DD1984/roboremo_car/photo/car1.jpg

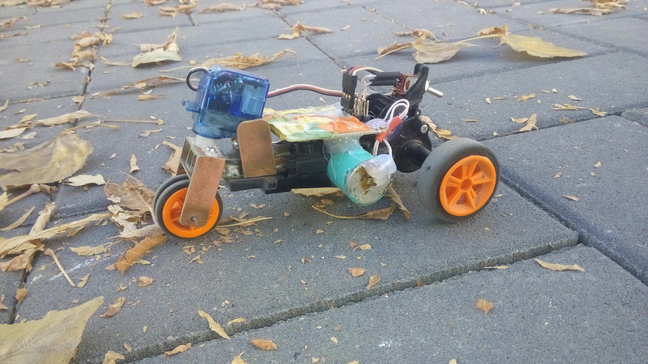
photo/car1.jpg
