DD1984/roboremo_car/photo/car2.jpg

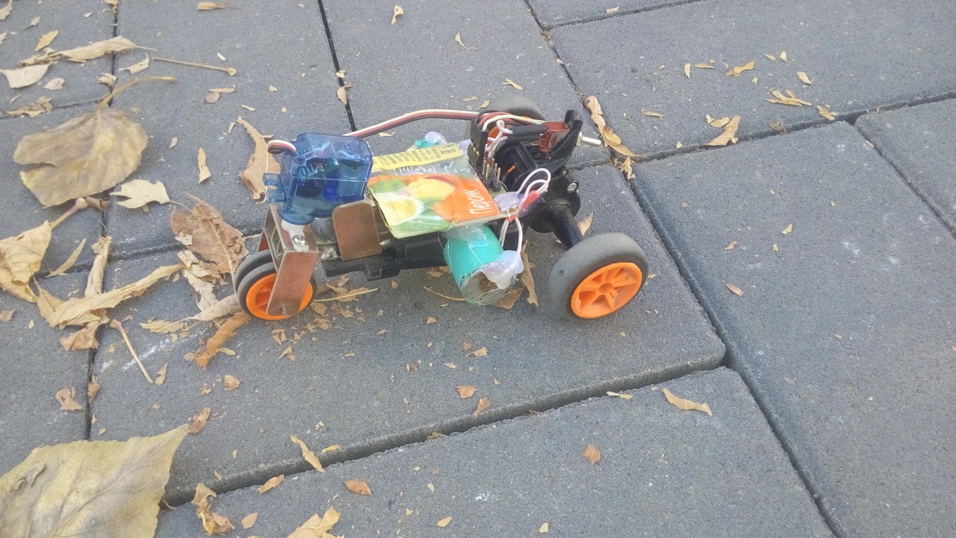
photo/car2.jpg
