DD1984/roboremo_car/pcb/rc.brd

## EAGLE design pcb/rc.brd (2018-10-22)

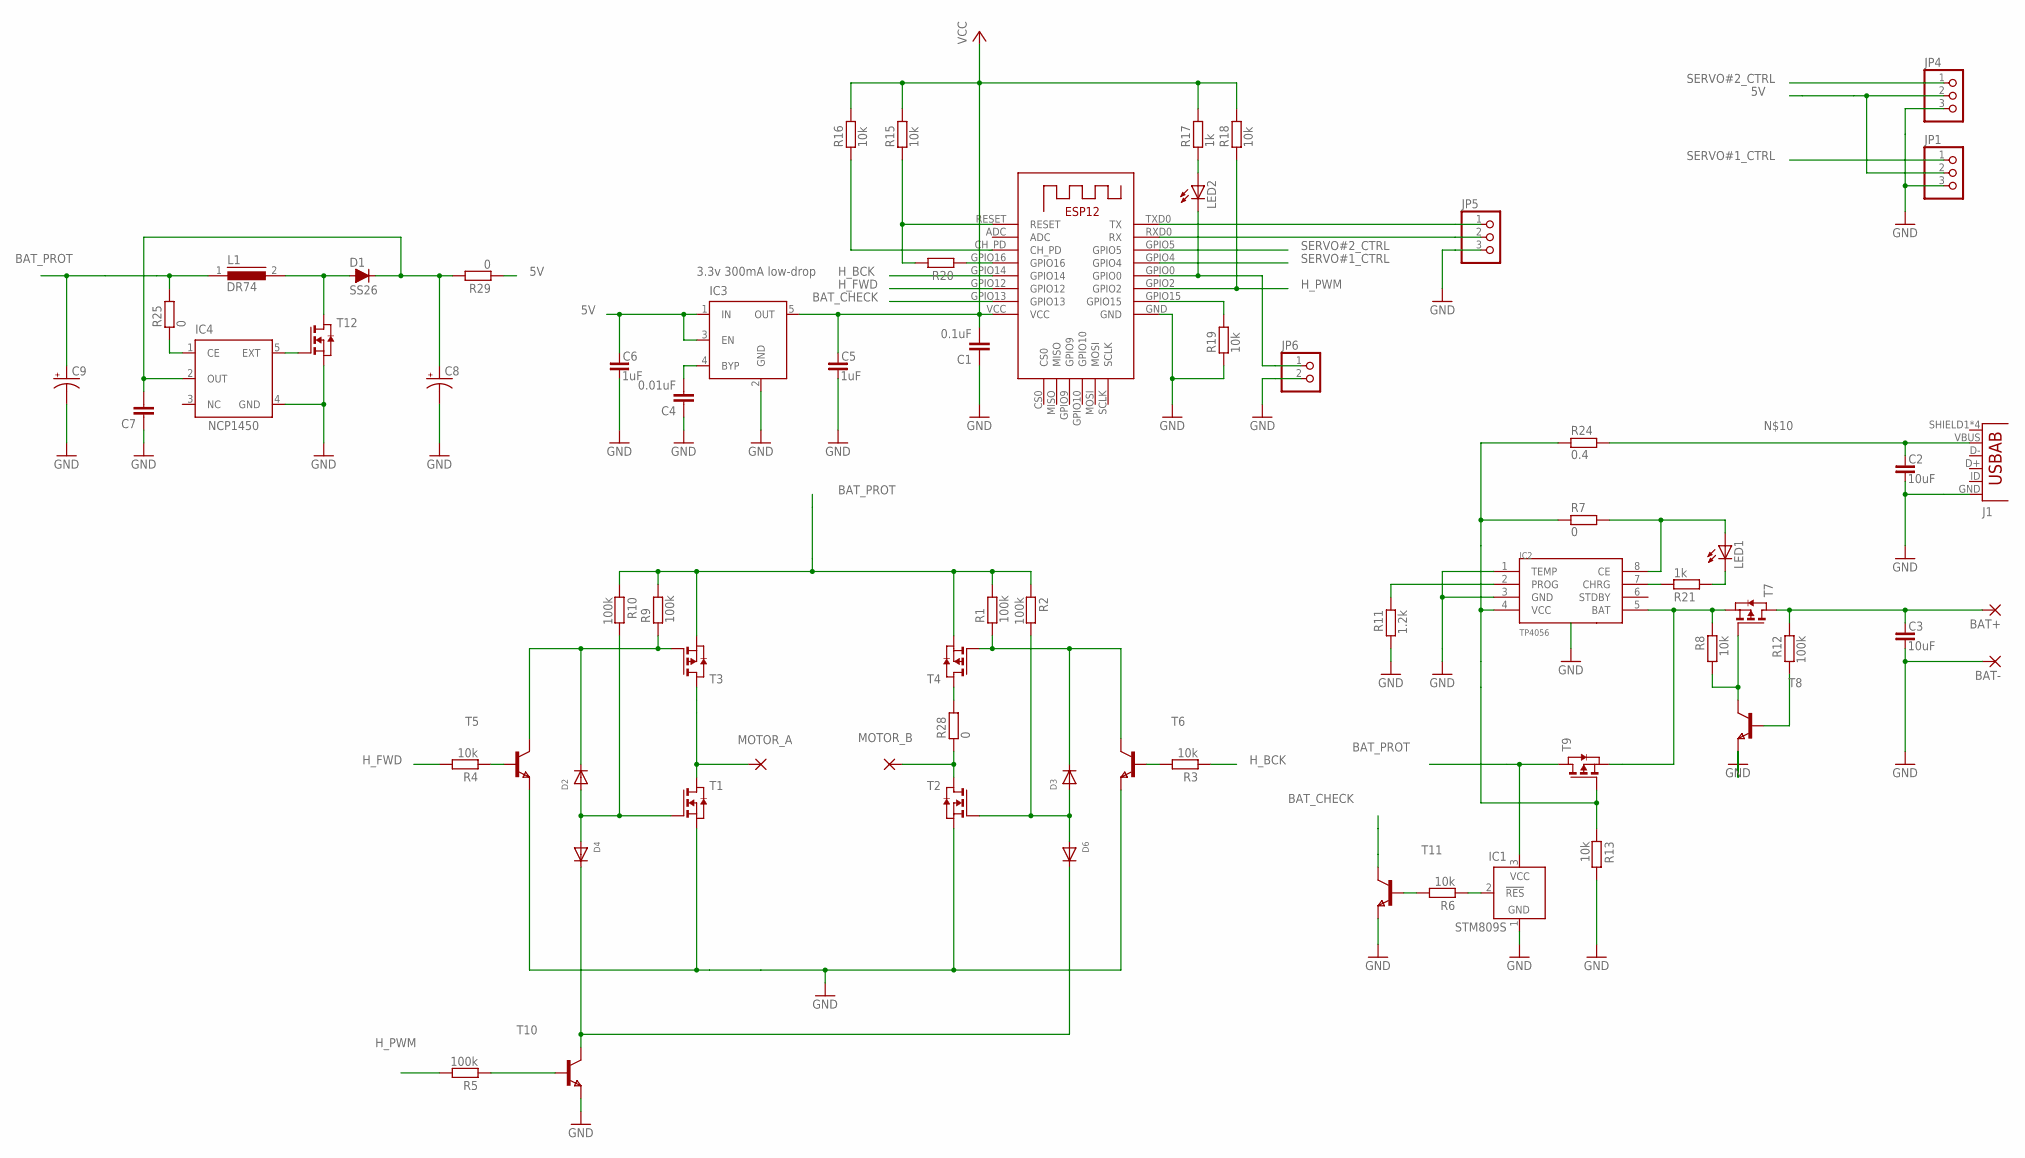
[picture p3: schematic rc.sch]

Parts:
BAT+: WIREPADSMD5-2,5; 5-2,5
BAT-: WIREPADSMD5-2,5; 5-2,5
C1: 0.1uF; C0805
C2, C3: 10uF; C1206
C4: 0.01uF; C0805
C5, C6: 1uF; C0805
C7: C-EUC0805; C0805
C8, C9: CPOL-USCT6032; CT6032
D1: SS26; SMB
D2, D3, D4, D6: DIODE_SOD-123FL; SOD-123FL
IC1: STM809S; SOT23B-3
IC2: TP4056; SOP-8
IC3: 3.3v 300mA low-drop; SOT23-5
IC4: NCP1450; SOT23-5
J1: USB-AB; USB-AB-MICRO-SMD
JP1, JP4, JP5: PINHD-1X3; 1X03
JP6: PINHD-1X2; 1X02
L1: DR74
LED1, LED2: LEDCHIPLED_0805; CHIPLED_0805
MOTOR_A: WIREPADSMD5-2,5; 5-2,5
MOTOR_B: WIREPADSMD5-2,5; 5-2,5
R1, R2, R5, R9, R10, R12: 100k; R0805
R3, R4, R6, R8, R13, R15, R16, R18, R19: 10k; R0805
R7, R25, R28, R29: 0; R1206
R11: 1.2k; R0805
R17, R21: 1k; R0805
R20: R_0805; R0805
R24: 0.4; R1206
T1, T2, T12: NMOSSOT23; SOT-23
T3, T4, T7, T9: PMOSSOT23; SOT-23
T5, T6, T8, T10, T11: NPNSOT23; SOT-23
U1: ESP-12

Connections:
5V: C6.1, IC3.1 (IN), IC3.3 (EN), JP1.2, JP4.2, R29.1
BAT+: BAT+.1, C3.1, R12.1, T7.1 (D)
BAT_CHECK: T11.1 (C), U1.GPIO13
BAT_CHRG: IC2.5 (BAT), R8.1, T7.2 (S), T9.2 (S)
BAT_PROT: C9.+, IC1.3 (VCC), L1.1, R1.2, R2.1, R9.2, R10.1, R25.2, T3.2 (S), T4.2 (S), T9.1 (D)
GND: BAT-.1, C1.1, C2.2, C3.2, C4.1, C5.2, C6.2, C7.1, C8.-, C9.-, IC1.1 (GND), IC2.1 (TEMP), IC2.3 (GND), IC2.HEATSINK, IC3.2 (GND), IC4.4 (GND), J1.GND, JP1.3, JP4.3, JP5.3, JP6.2, R11.2, R13.2, R19.1, T1.2 (S), T2.2 (S), T5.2 (E), T6.2 (E), T8.2 (E), T10.2 (E), T11.2 (E), T12.2 (S), U1.GND
H_BCK: R3.1, U1.GPIO14
H_FWD: R4.2, U1.GPIO12
H_PWM: R5.2, R18.1, U1.GPIO2
unnamed: D2.C, R9.1, T3.3 (G), T5.1 (C)
unnamed: IC2.8 (CE), LED1.A, R7.2
unnamed: D1.2 (A), L1.2, T12.1 (D)
unnamed: MOTOR_B.1, R28.1, T2.1 (D)
unnamed: R4.1, T5.3 (B)
unnamed: D2.A, D4.A, R10.2, T1.3 (G)
unnamed: R3.2, T6.3 (B)
unnamed: D3.C, R1.1, T4.3 (G), T6.1 (C)
unnamed: D3.A, D6.A, R2.2, T2.3 (G)
unnamed: C2.1, J1.VBUS, R24.2
unnamed: IC2.2 (PROG), R11.1
unnamed: R8.2, T7.3 (G), T8.1 (C)
unnamed: R6.2, T11.3 (B)
unnamed: R28.2, T4.1 (D)
unnamed: IC4.5 (EXT), T12.3 (G)
unnamed: R12.2, T8.3 (B)
unnamed: IC1.2 (!RES), R6.1
unnamed: IC4.1 (CE), R25.1
unnamed: R15.1, R20.2, U1.RESET
unnamed: R16.1, U1.CH_PD
unnamed: JP6.1, LED2.C, U1.GPIO0
unnamed: R20.1, U1.GPIO16
unnamed: LED2.A, R17.1
unnamed: C4.2, IC3.4 (BYP)
unnamed: R19.2, U1.GPIO15
unnamed: LED1.C, R21.2
unnamed: IC2.7 (CHRG), R21.1
unnamed: C7.2, C8.+, D1.1 (C), IC4.2 (OUT), R29.2
unnamed: D4.C, D6.C, T10.1 (C)
unnamed: R5.1, T10.3 (B)
unnamed: MOTOR_A.1, T1.1 (D), T3.1 (D)
RX: JP5.2, U1.RXD0 (RX)
SERVO#1_CTRL: JP1.1, U1.GPIO4
SERVO#2_CTRL: JP4.1, U1.GPIO5
TX: JP5.1, U1.TXD0 (TX)
VCC: C1.2, C5.1, IC3.5 (OUT), R15.2, R16.2, R17.2, R18.2, U1.VCC
V_CHRG: IC2.4 (VCC), R7.1, R13.1, R24.1, T9.3 (G)

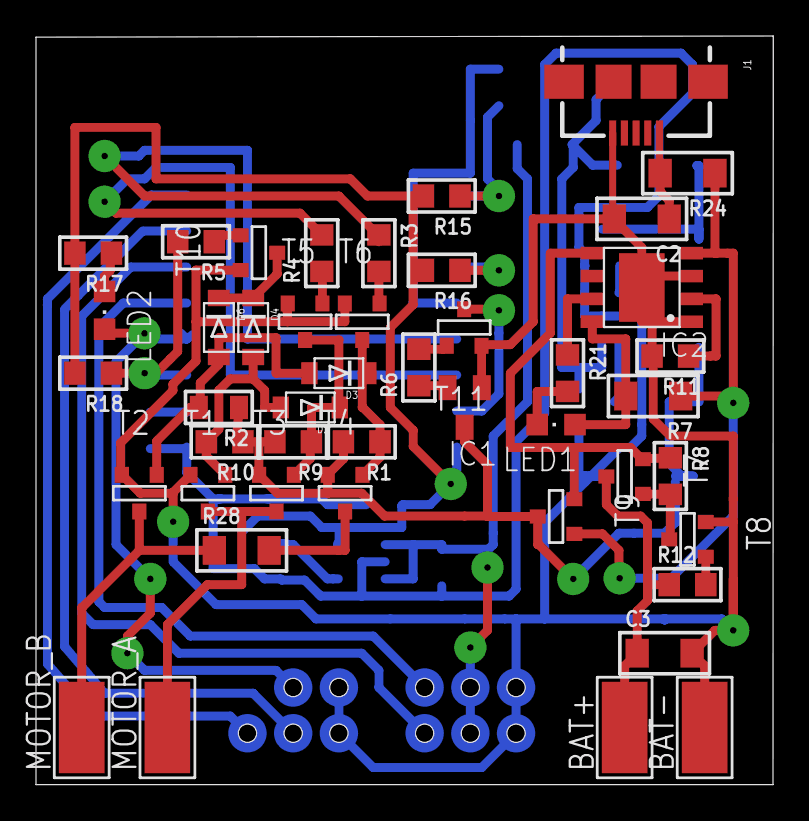
[picture p4: board rc.brd from above]

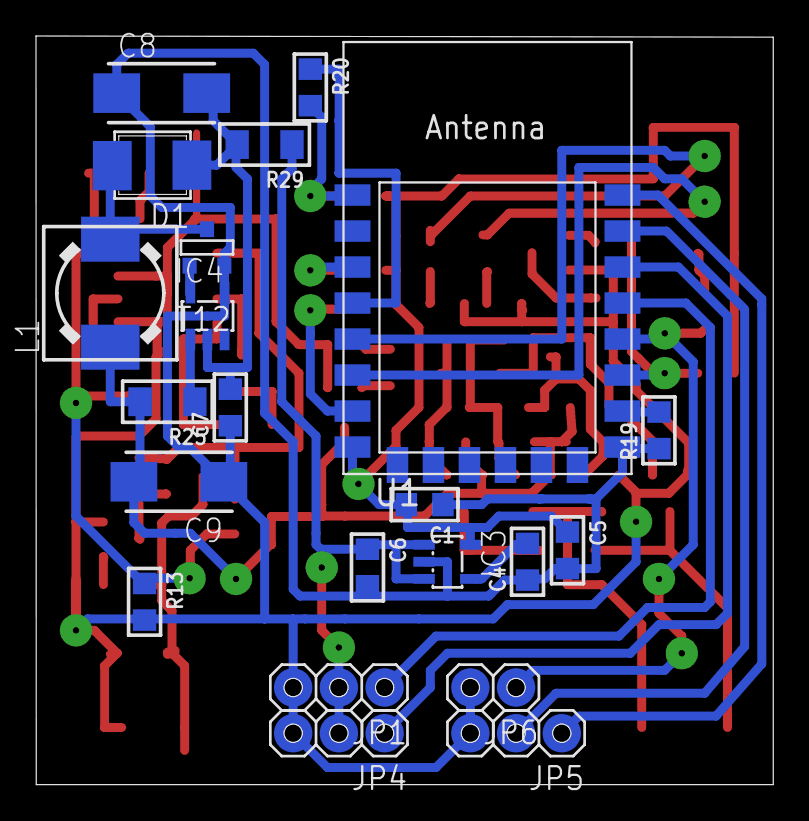
[picture p5: board rc.brd from below]

Board: 2 copper layers, 41.0 x 41.6 mm, 67 parts (22 on the bottom side), 46 nets.
