DD1984/roboremo_car/(commit log)

2018-09-20 add pcb
    [rc.brd, rc.sch]
2018-09-25 add led api
2018-09-25 move led ctrl from loop() to ticker
2018-09-25 remove int16_t servo_val
2018-09-28 scheme: change H-bridge and battety check
    [rc.brd, rc.sch]
2018-10-02 add servo trimmer
2018-10-02 change trim function from 2 buttons to one slider for save roboremo ctrls
2018-10-08 begin pcb v2
    [rc.brd, rc.sch]
2018-10-21 pcb 0.5mm
    [rc.brd]
2018-10-22 piout for new pcb
2018-10-22 add values for some components
    [rc.brd, rc.sch]
2018-10-28 multi servos
